oats-center/data-diode/DATA_DIODE_FINAL/mobile/README.md

# Data diode demo mobile app

To start:

```
npm install
npm run dev -- --open
```

# Emulate the position to intersection service

```
nats -s <nats-ip> --user <user> --password <password> reply "light-nearest" '{"intersectionId": 53694, "signalGroup": 4}'
```

# Emulate a GREEN light status update

```
nats -s <server> --user <user> --password <password> publish light-status.53694 '{"id": "53694", "current_time": 1673997750736, "TSCtime": "49947.0", "phases": [{"phase": 1, "color": "RED", "flash": false, "dont_walk": true, "walk": false, "pedestrianClear": false, "overlap": {"green": false, "red":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
```

# Emulate a RED light status update

```
nats -s <server> --user <user> --password <password> publish light-status.53694 '{"id": "53694", "current_time": 1673997750736, "TSCtime": "49947.0", "phases": [{"phase": 1, "color": "RED", "flash": false, "dont_walk": true, "walk": false, "pedestrianClear": false, "overlap": {"green": false, "red":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
```
