oats-center/data-diode/DATA_DIODE_FINAL/NTGS_Conference/NTGS_Conference.pdf

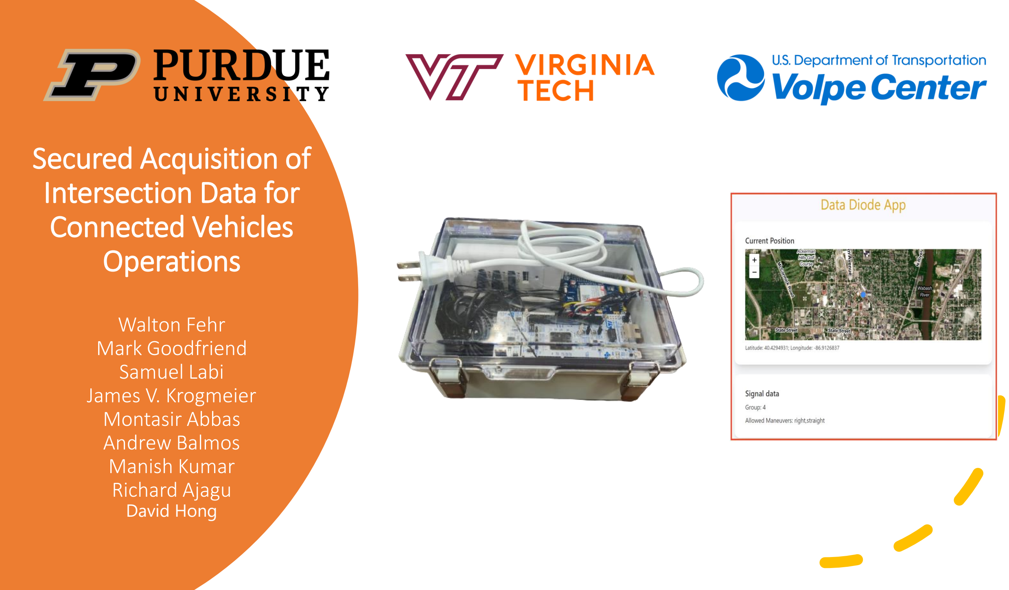
[picture p2: page 1]

Secured Acquisition of
Intersection Data for
Connected Vehicles
Operations

Walton Fehr
Mark Goodfriend
Samuel Labi
James V. Krogmeier
Montasir Abbas
Andrew Balmos
Manish Kumar
Richard Ajagu
David Hong

- Objective is to extract Signal Phase and Timing (SPaT) data from a Traffic Signal Controller (TSC) cabinet
- Solution uses an economical Data-Diode housing two microcontrollers linked via simplex connection
- Diode data is routed to different channels through NATS and stored in Postgres database
- Utilize SPaT data to provide precise timing on driver’s phone
- Backend script detects user location and finds nearest intersection
- User's phone shows TSC lane's light status

Secured Acquisition of Intersection Data for Connected Vehicles Operations

## TSC Cabinet

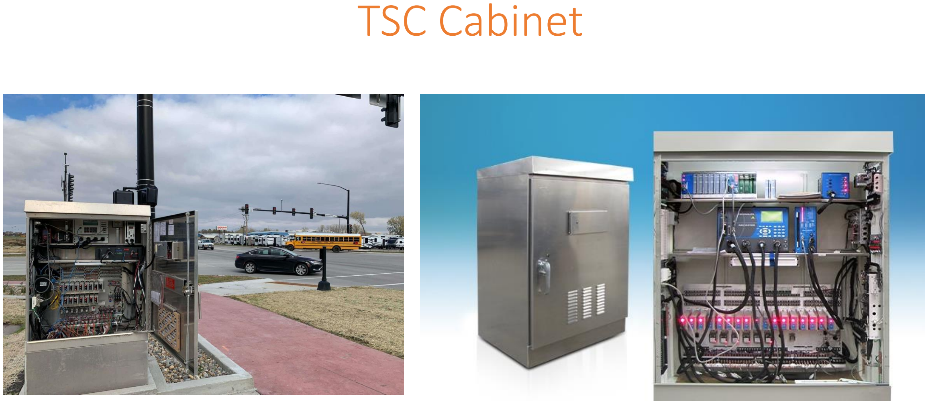
[picture p3: page 3]

## System Workflow

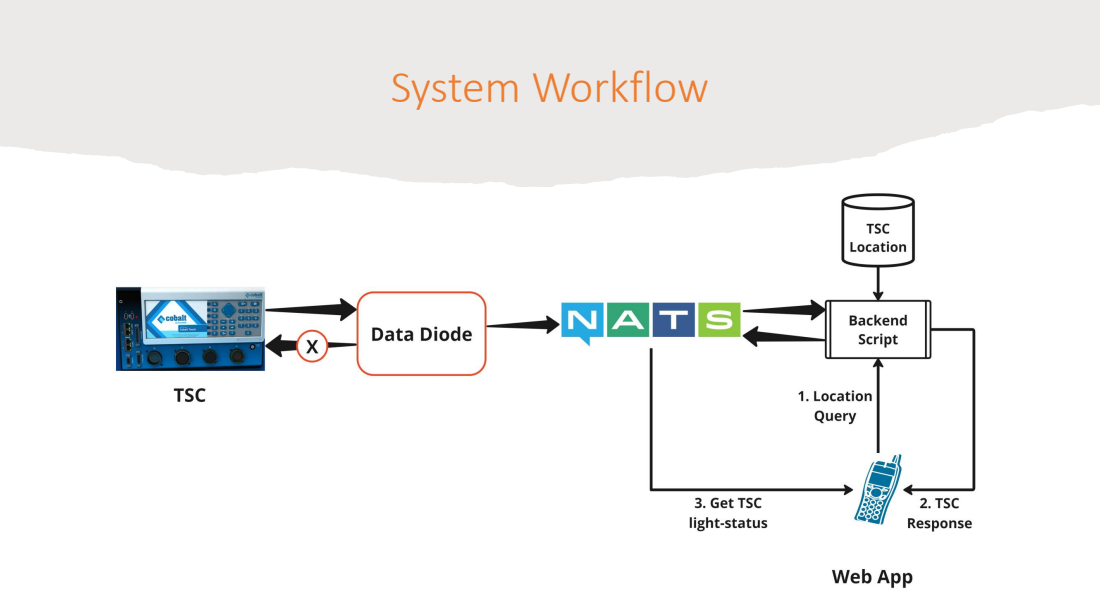
[picture p4: page 4]

## Data-Diode

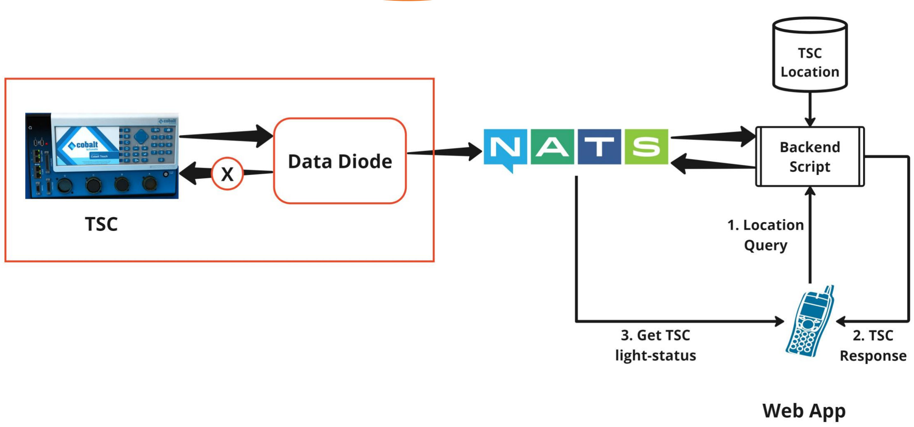
[picture p5: figure]

## Data-Diode

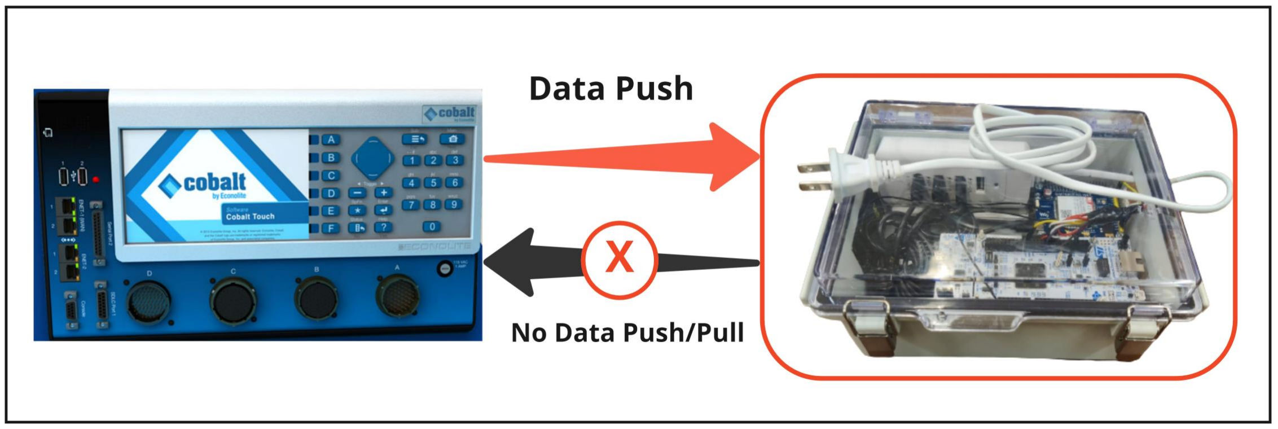
[picture p6: figure]

Components of Data Diode

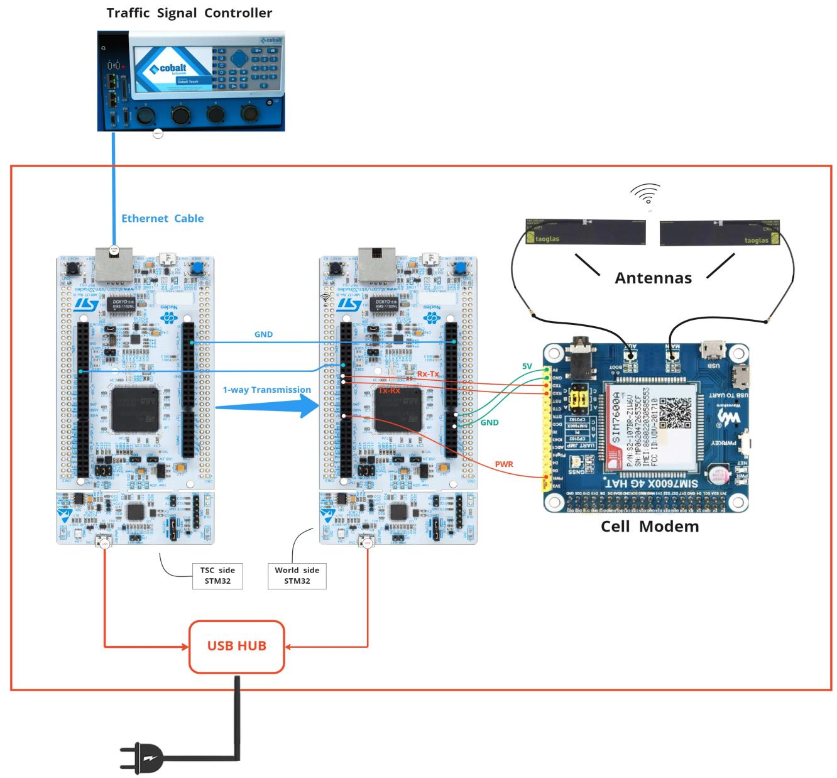
[picture p7: figure]

### NATS Data Routing

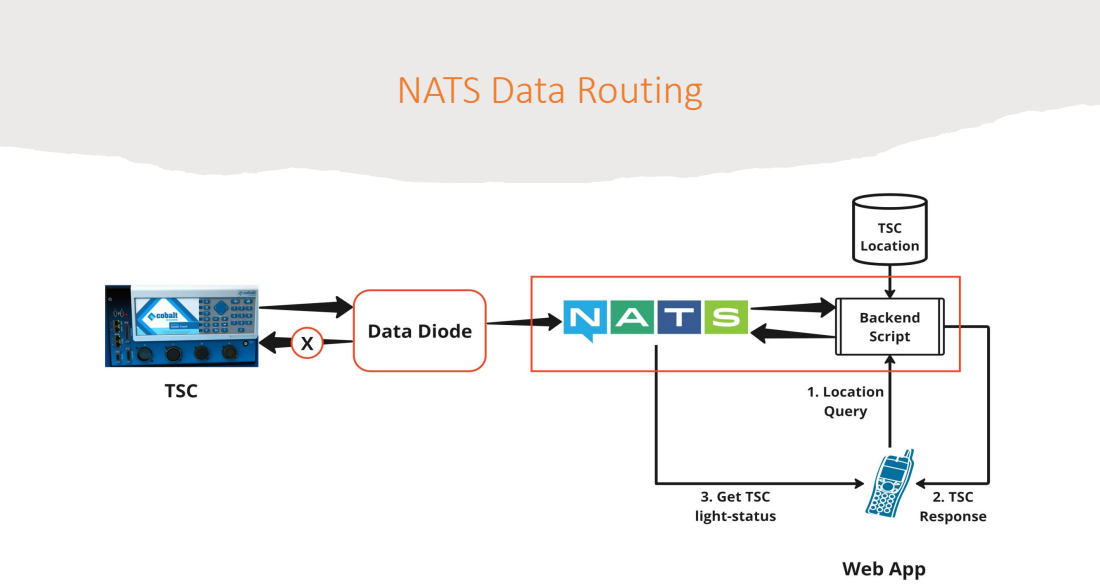
[picture p8: page 8]

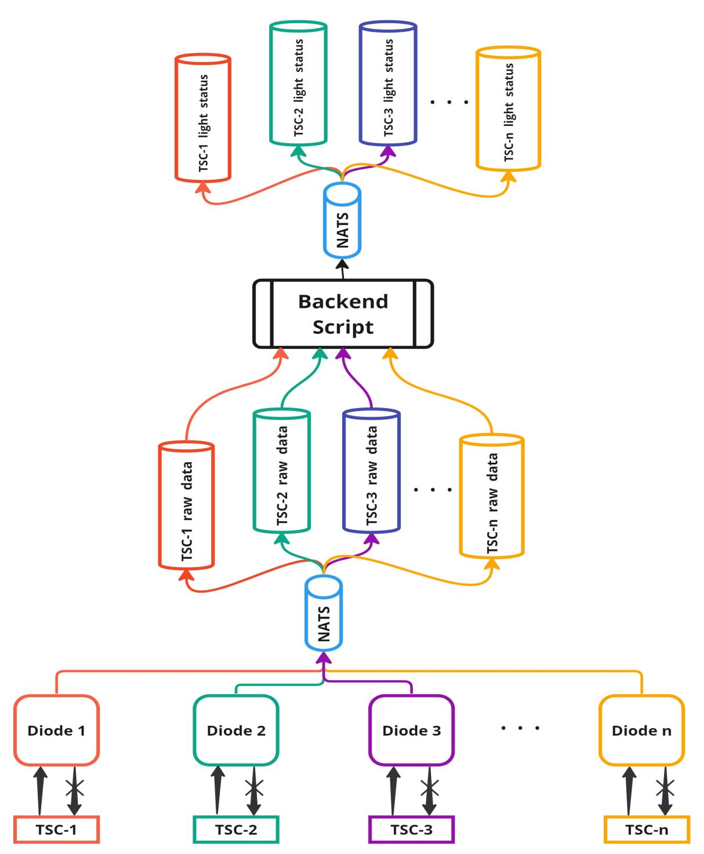
[picture p9: figure]

## Web App

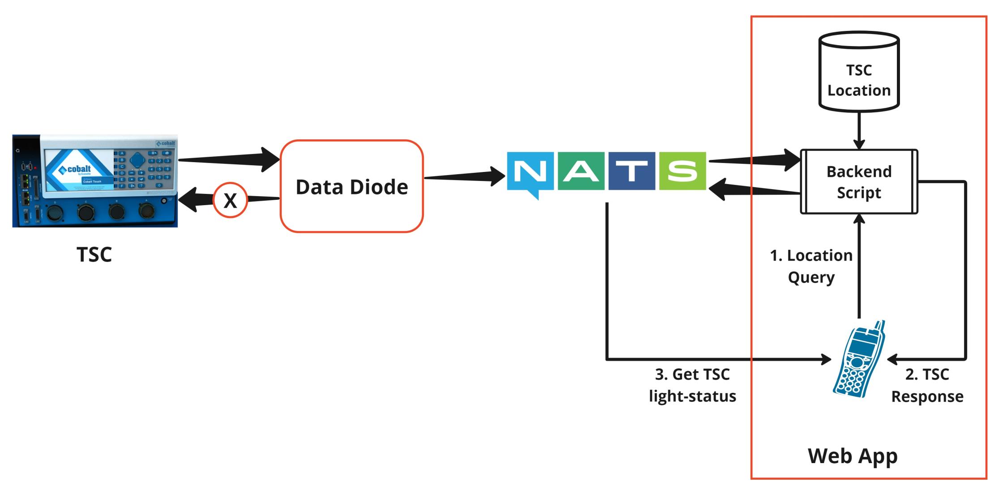
[picture p10: page 10]

## Web App - Backend

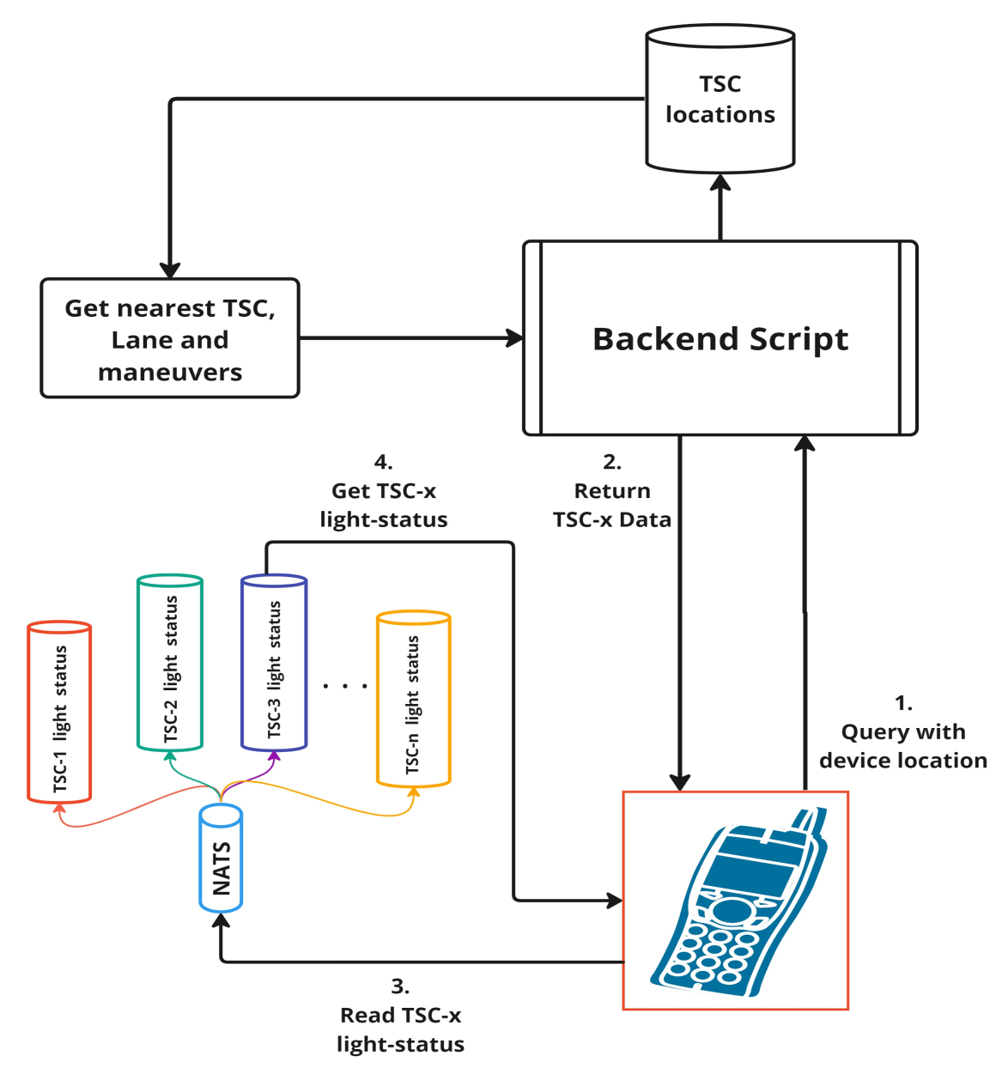
[picture p11: figure]

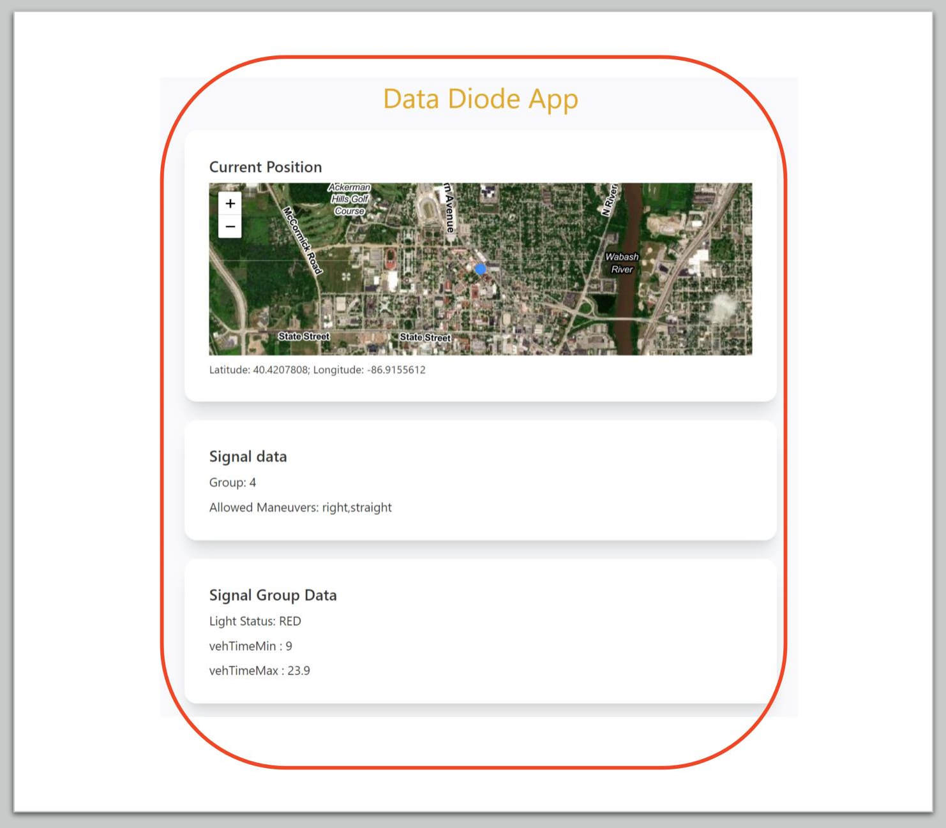
[picture p12: figure]

Web App - Frontend
https://diode.oatscenter.org/
1. Query the server with
coordinates
2. Obtain the Traffic Light status in its lane
3. Display the Light status

## Installation – Plug n Play!

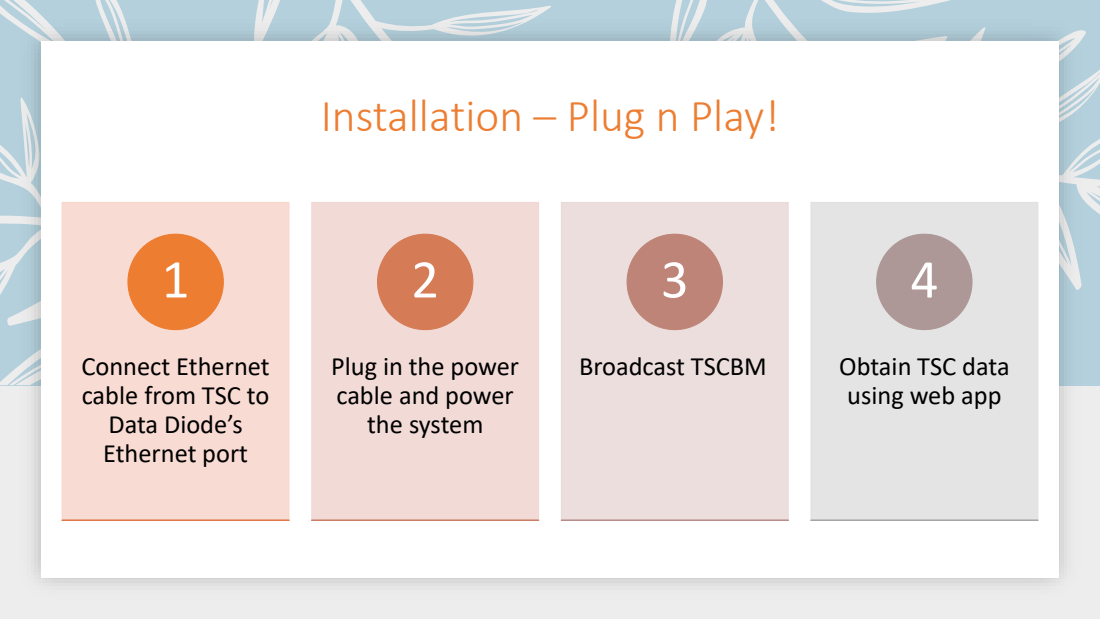
[picture p13: page 13]
Broadcast TSCBM

Connect Ethernet
cable from TSC to
Data Diode’s
Ethernet port

Plug in the power
cable and power
the system

Obtain TSC data
using web app

## Data Diode Goals

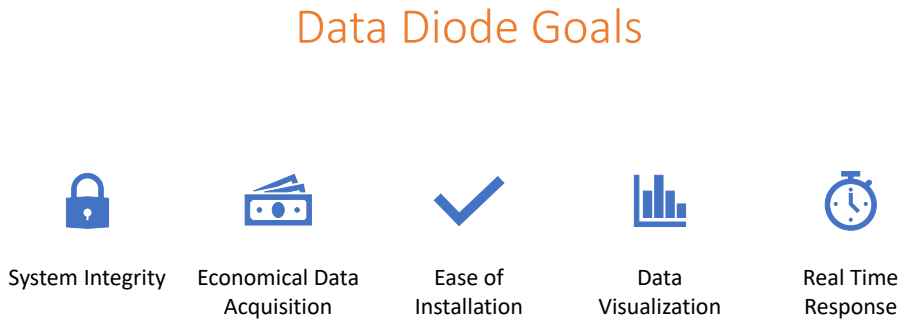
[picture p14: page 14]
System Integrity; Economical Data; Acquisition; Ease of Installation; Data Visualization; Real Time Response

### Demo & Questions

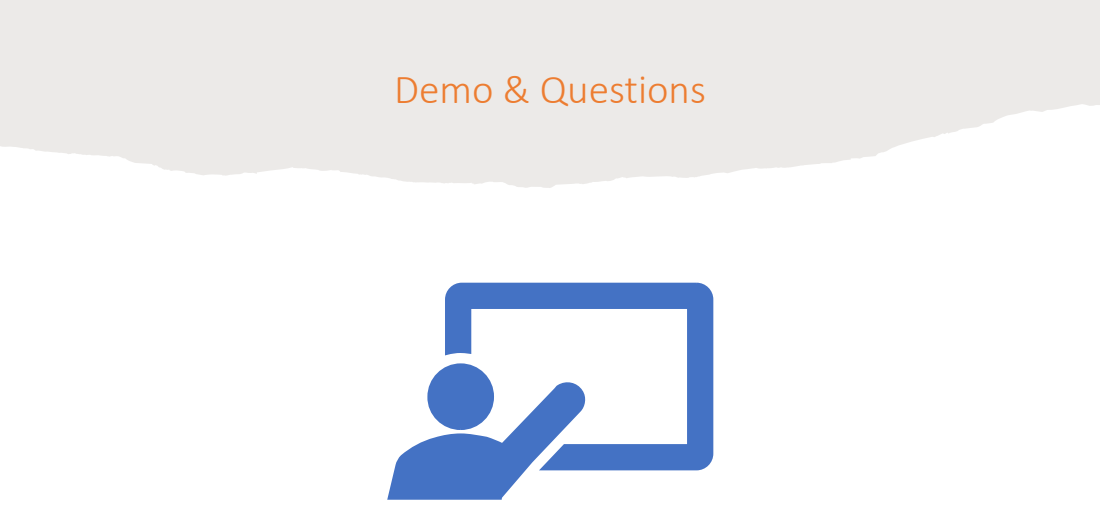
[picture p15: page 15]
