oats-center/data-diode/DATA_DIODE_FINAL/PCB/dev-boards/models/BCS-117-L-D-TE.stp

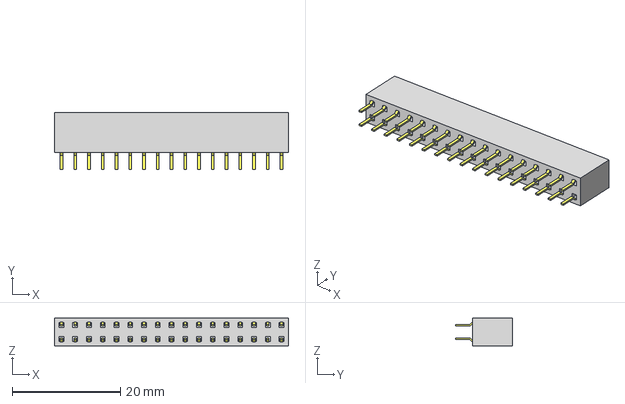
[picture p16: CAD file, 2024-01-05]
DATA_DIODE_FINAL/PCB/dev-boards/models/BCS-117-L-D-TE.stp
43.2 x 10.5 x 5.08 mm
C-95-01-17-D-TE
BCS-117-D-TE_socket
