oats-center/data-diode/DATA_DIODE_FINAL/PCB/dev-boards/models/BCS-115-L-D-TE.stp

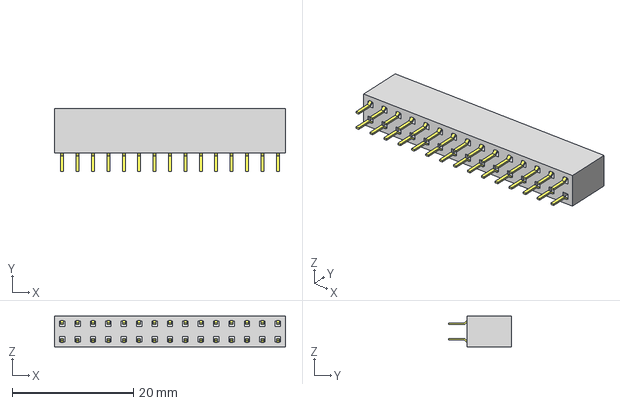
[picture p17: CAD file, 2024-01-05]
DATA_DIODE_FINAL/PCB/dev-boards/models/BCS-115-L-D-TE.stp
38.1 x 10.5 x 5.08 mm
C-95-01-15-D-TE
BCS-115-D-TE_socket
