oats-center/data-diode/DATA_DIODE_FINAL/PCB/dev-boards/models/BCS-110-F-D-TE.stp

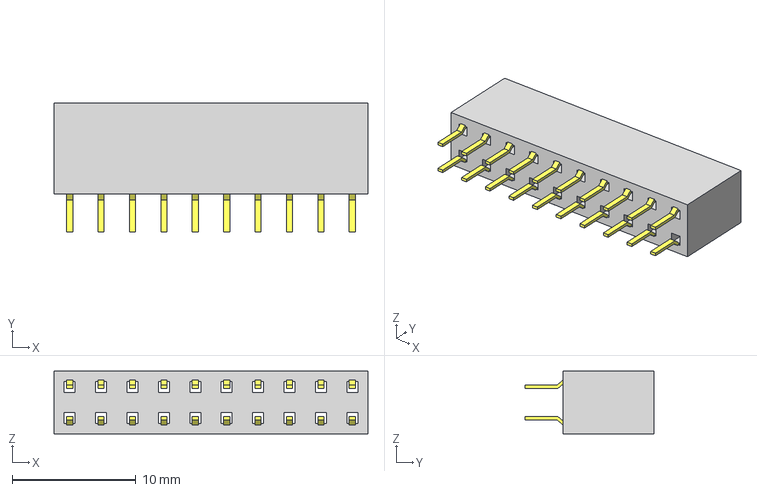
[picture p18: CAD file, 2024-01-05]
DATA_DIODE_FINAL/PCB/dev-boards/models/BCS-110-F-D-TE.stp
25.4 x 10.5 x 5.08 mm
C-95-01-10-D-TE
BCS-110-D-TE_socket
