oats-center/data-diode/DATA_DIODE_FINAL/PCB/dev-boards/models/BCS-108-F-D-TE.stp

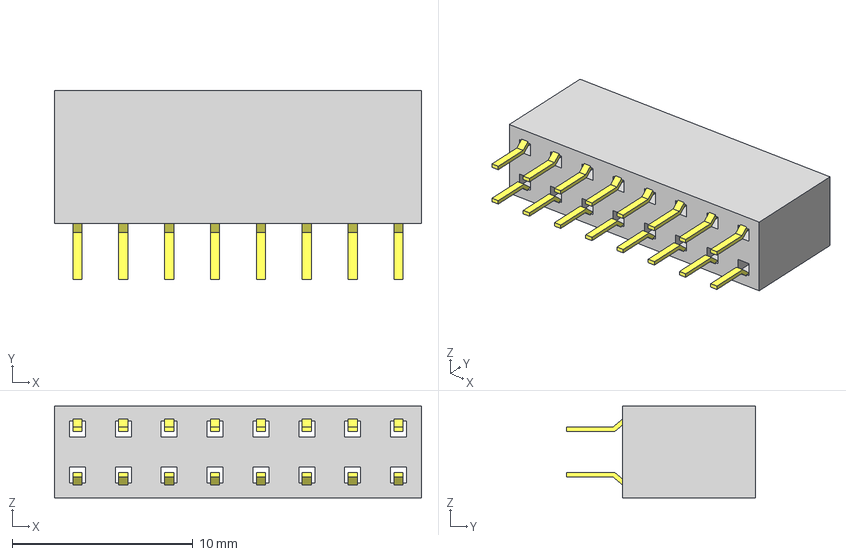
[picture p19: CAD file, 2024-01-05]
DATA_DIODE_FINAL/PCB/dev-boards/models/BCS-108-F-D-TE.stp
20.3 x 10.5 x 5.08 mm
C-95-01-08-D-TE
BCS-108-D-TE_socket
