oats-center/data-diode/DATA_DIODE_FINAL/PCB/dev-boards/models/WQ-48-02-Just-Box.step

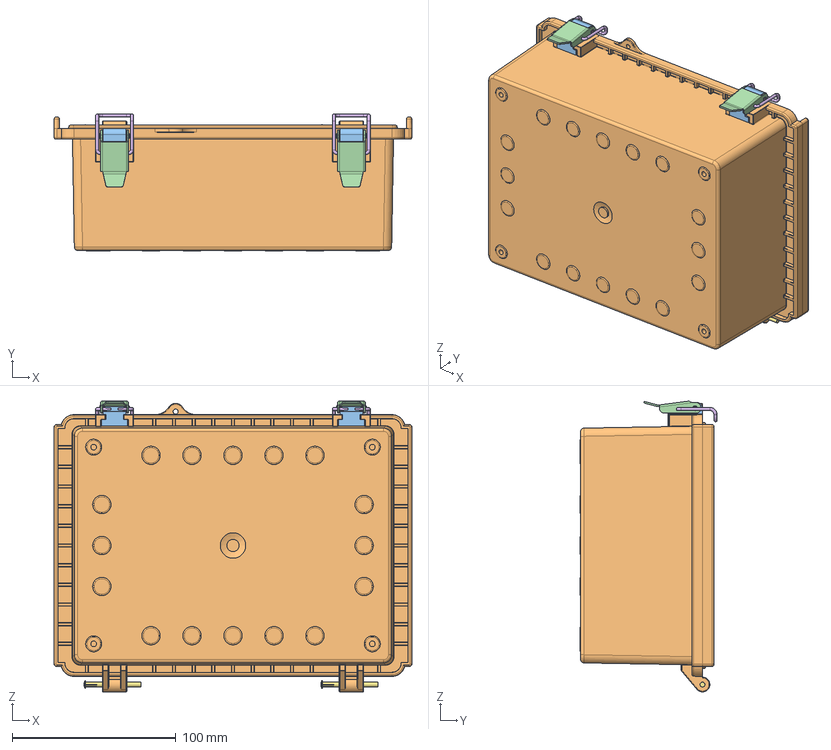
[picture p20: CAD file, 2024-01-05]
DATA_DIODE_FINAL/PCB/dev-boards/models/WQ-48-02-Just-Box.step
218.4 x 83.8 x 177.5 mm
WQ-48B_WQ-48B-02
WQ-48C_WQ-48C-02
BASE^WQ-50L-01 x 2
FRONT^WQ-50L-01_default x 2
PIN^WQ-50L-01 x 2
LOOP^WQ-50L-01 x 2
WQ-PIN-01 x 2
