oats-center/data-diode/DATA_DIODE_FINAL/PCB/new-dev-board/new-dev-board.kicad_pcb

## KiCad design DATA_DIODE_FINAL/PCB/new-dev-board/new-dev-board.kicad_pcb (2024-01-05)

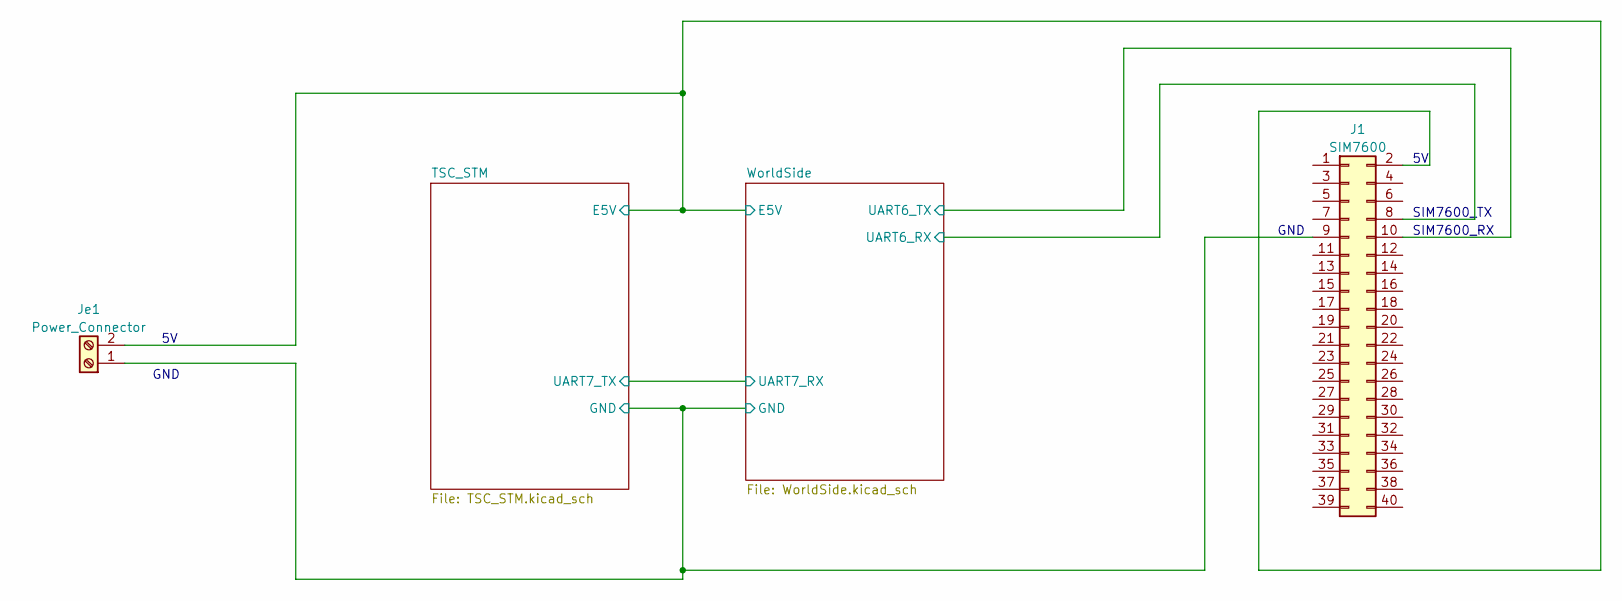
[picture p21: schematic new-dev-board.kicad_sch]

Parts:
J1: SIM7600
Je1: Power_Connector; TerminalBlock_Phoenix_MKDS-1,5-2-5.08_1x02_P5.08mm_Horizont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

Connections:
/TSC_STM/E5V: J1.2, Je1.2; also elsewhere on the board
/TSC_STM/GND: J1.9, Je1.1; also elsewhere on the board
/WorldSide/UART6_RX: J1.8; also elsewhere on the board
/WorldSide/UART6_TX: J1.10; also elsewhere on the board

Notes on the sheet:
GND
SIM7600_TX
SIM7600_RX

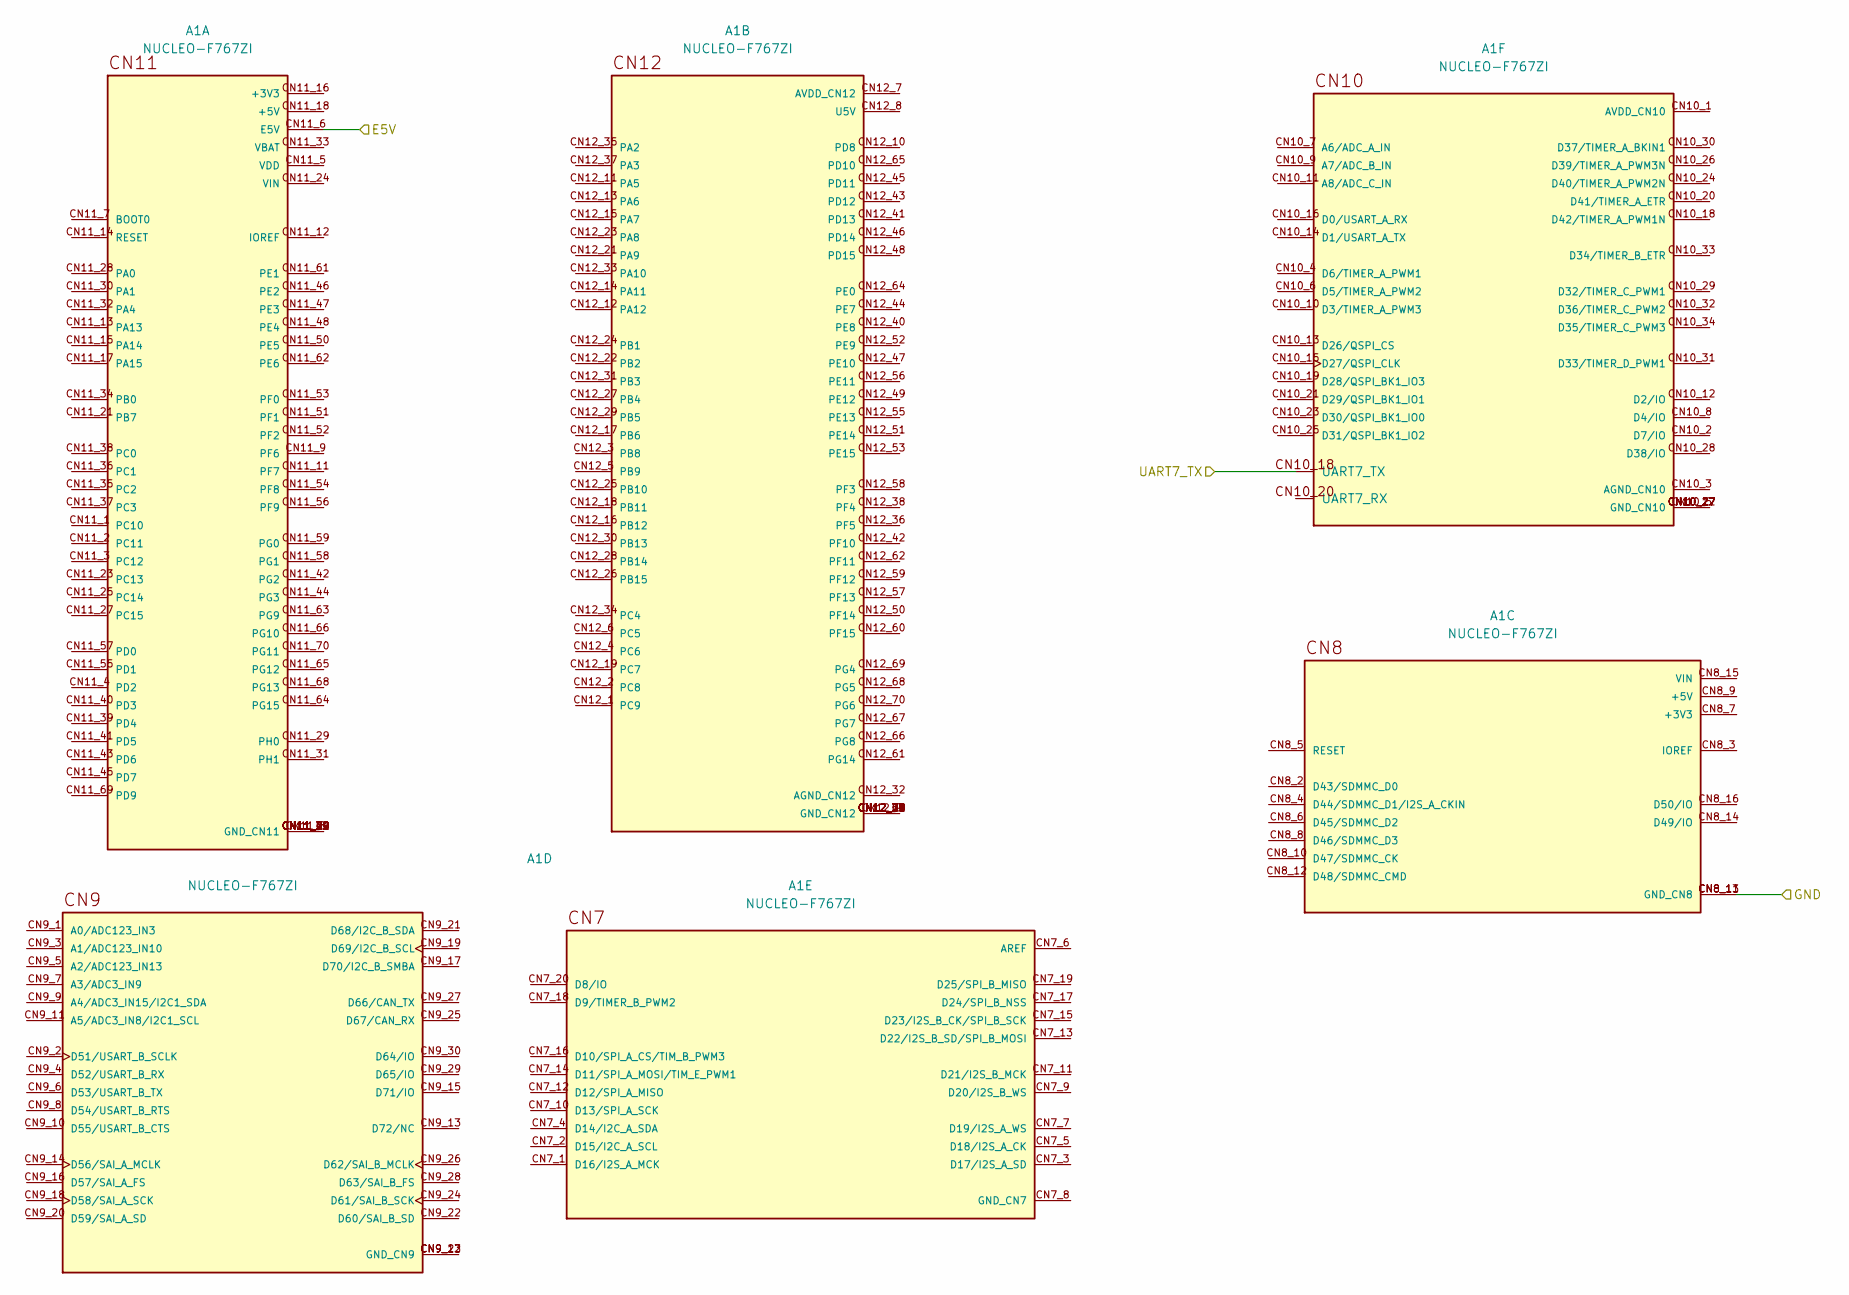
[picture p22: schematic TSC_STM.kicad_sch]

Parts:
A1: NUCLEO-F767ZI; PARTREV 7

Connections:
/TSC_STM/E5V: A1.CN11_6 (E5V); also elsewhere on the board
/TSC_STM/GND: A1.CN8_11 (GND_CN8), A1.CN8_13 (GND_CN8); also elsewhere on the board
/TSC_STM/UART7_TX: A1.CN10_18 (UART7_TX); also elsewhere on the board
unnamed: A1.CN11_8 (GND_CN11), A1.CN11_19 (GND_CN11), A1.CN11_20 (GND_CN11), A1.CN11_22 (GND_CN11), A1.CN11_49 (GND_CN11), A1.CN11_60 (GND_CN11), A1.CN11_71 (GND_CN11), A1.CN11_72 (GND_CN11)
unnamed: A1.CN12_9 (GND_CN12), A1.CN12_20 (GND_CN12), A1.CN12_39 (GND_CN12), A1.CN12_54 (GND_CN12), A1.CN12_63 (GND_CN12), A1.CN12_71 (GND_CN12), A1.CN12_72 (GND_CN12)
unnamed: A1.CN9_12 (GND_CN9), A1.CN9_23 (GND_CN9)
unnamed: A1.CN10_5 (GND_CN10), A1.CN10_17 (GND_CN10), A1.CN10_22 (GND_CN10), A1.CN10_27 (GND_CN10)

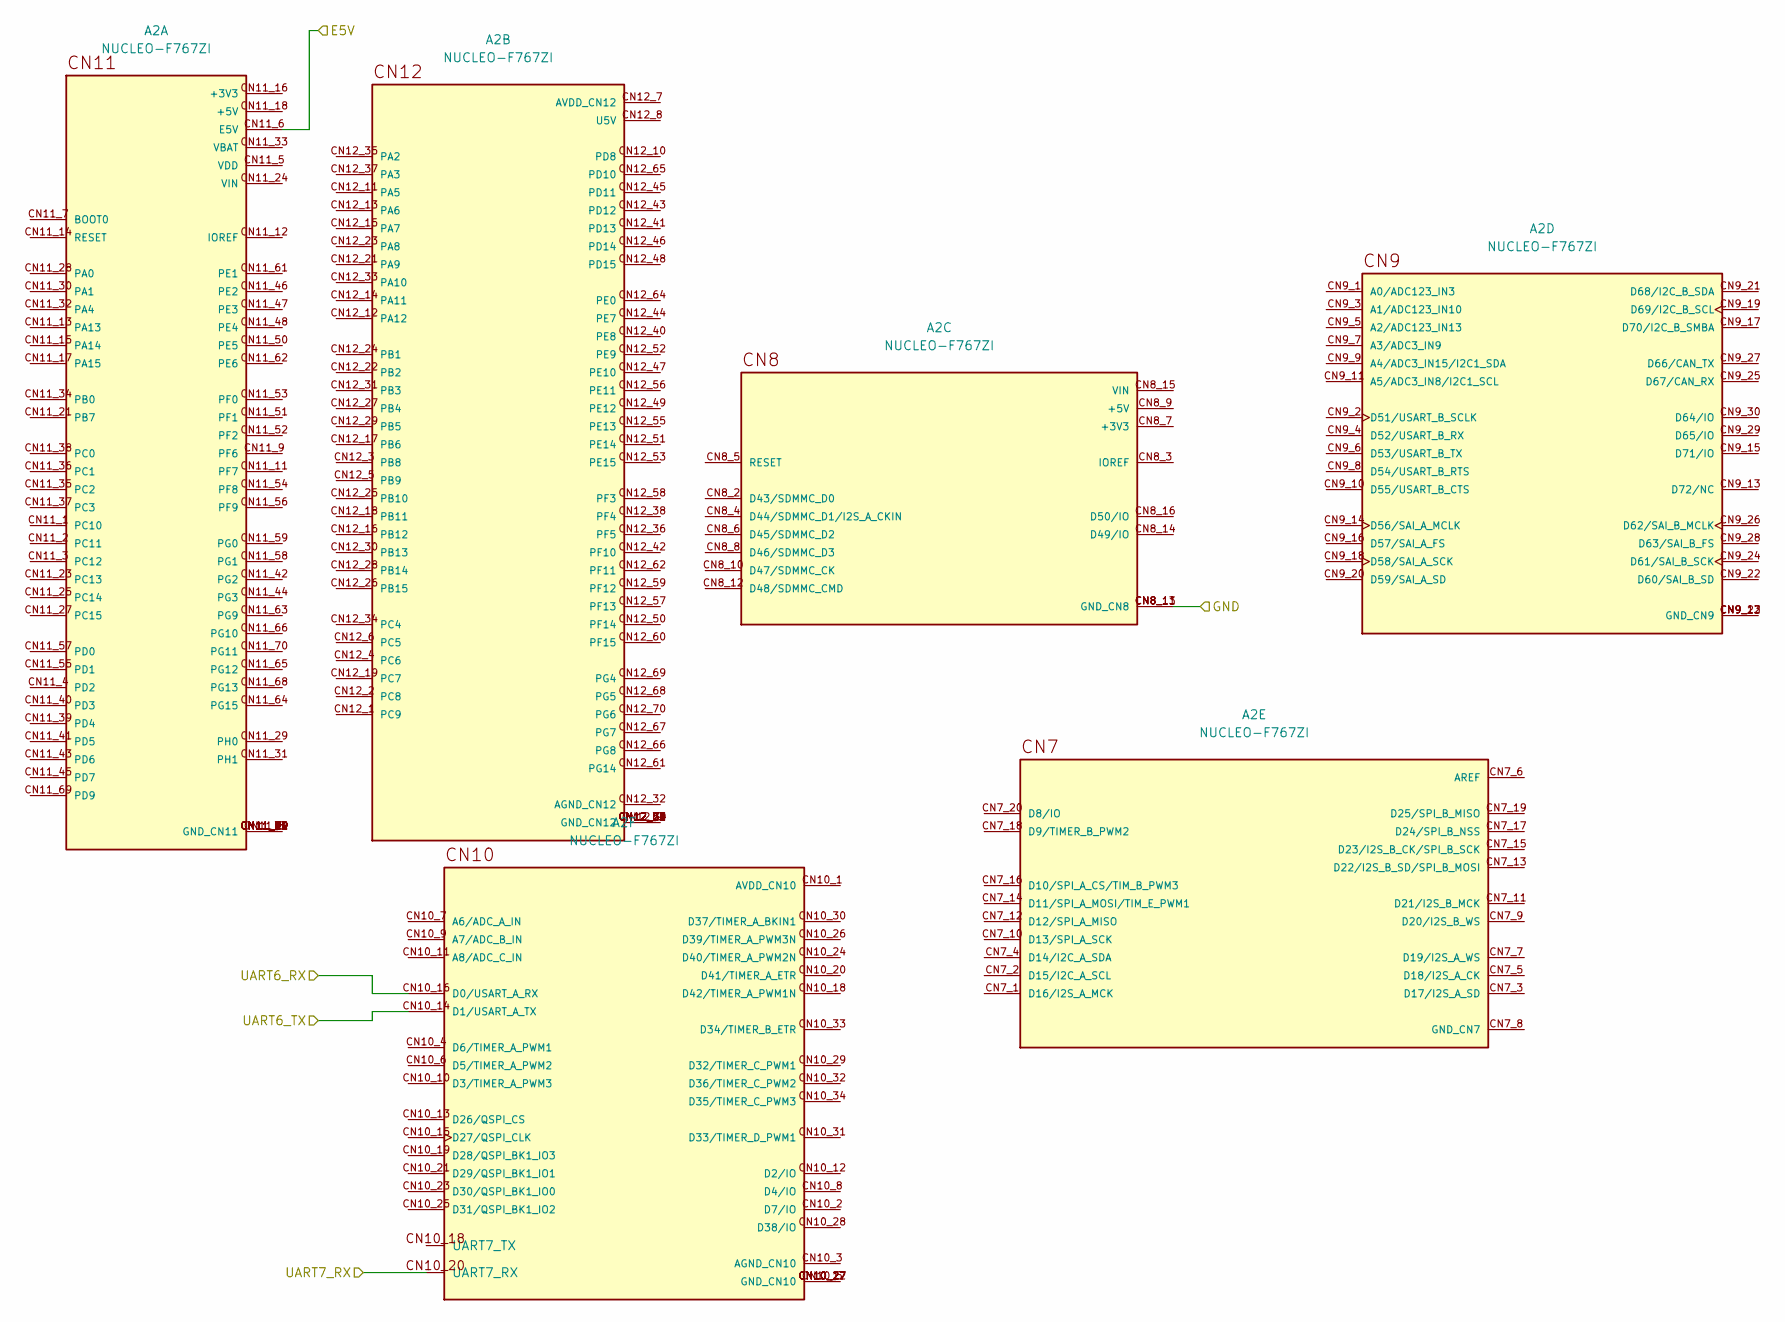
[picture p23: schematic WorldSide.kicad_sch]

Parts:
A2: NUCLEO-F767ZI; PARTREV 7

Connections:
/TSC_STM/E5V: A2.CN11_6 (E5V); also elsewhere on the board
/TSC_STM/GND: A2.CN8_11 (GND_CN8), A2.CN8_13 (GND_CN8); also elsewhere on the board
/TSC_STM/UART7_TX: A2.CN10_20 (UART7_RX); also elsewhere on the board
/WorldSide/UART6_RX: A2.CN10_16 (D0/USART_A_RX); also elsewhere on the board
/WorldSide/UART6_TX: A2.CN10_14 (D1/USART_A_TX); also elsewhere on the board
unnamed: A2.CN11_8 (GND_CN11), A2.CN11_19 (GND_CN11), A2.CN11_20 (GND_CN11), A2.CN11_22 (GND_CN11), A2.CN11_49 (GND_CN11), A2.CN11_60 (GND_CN11), A2.CN11_71 (GND_CN11), A2.CN11_72 (GND_CN11)
unnamed: A2.CN12_9 (GND_CN12), A2.CN12_20 (GND_CN12), A2.CN12_39 (GND_CN12), A2.CN12_54 (GND_CN12), A2.CN12_63 (GND_CN12), A2.CN12_71 (GND_CN12), A2.CN12_72 (GND_CN12)
unnamed: A2.CN9_12 (GND_CN9), A2.CN9_23 (GND_CN9)
unnamed: A2.CN10_5 (GND_CN10), A2.CN10_17 (GND_CN10), A2.CN10_22 (GND_CN10), A2.CN10_27 (GND_CN10)

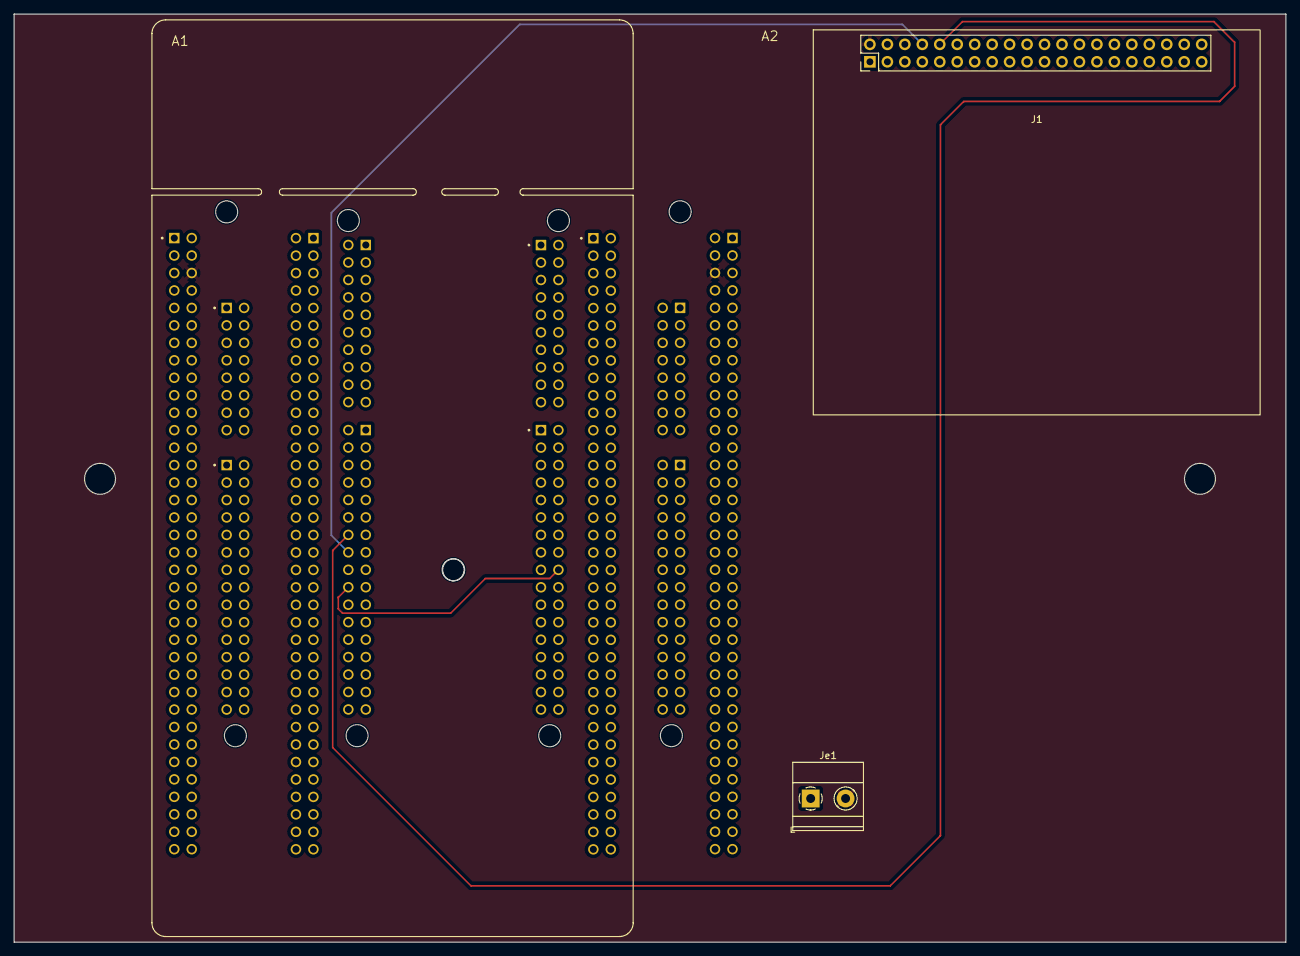
[picture p24: board new-dev-board.kicad_pcb from above]

Board: 2 copper layers, 185.0 x 135.0 mm, 4 parts (1 on the bottom side), 13 nets.
