oats-center/data-diode/DATA_DIODE_FINAL/PCB/dev-boards/dev-boards.kicad_pcb

## KiCad design DATA_DIODE_FINAL/PCB/dev-boards/dev-boards.kicad_pcb (2024-01-05)

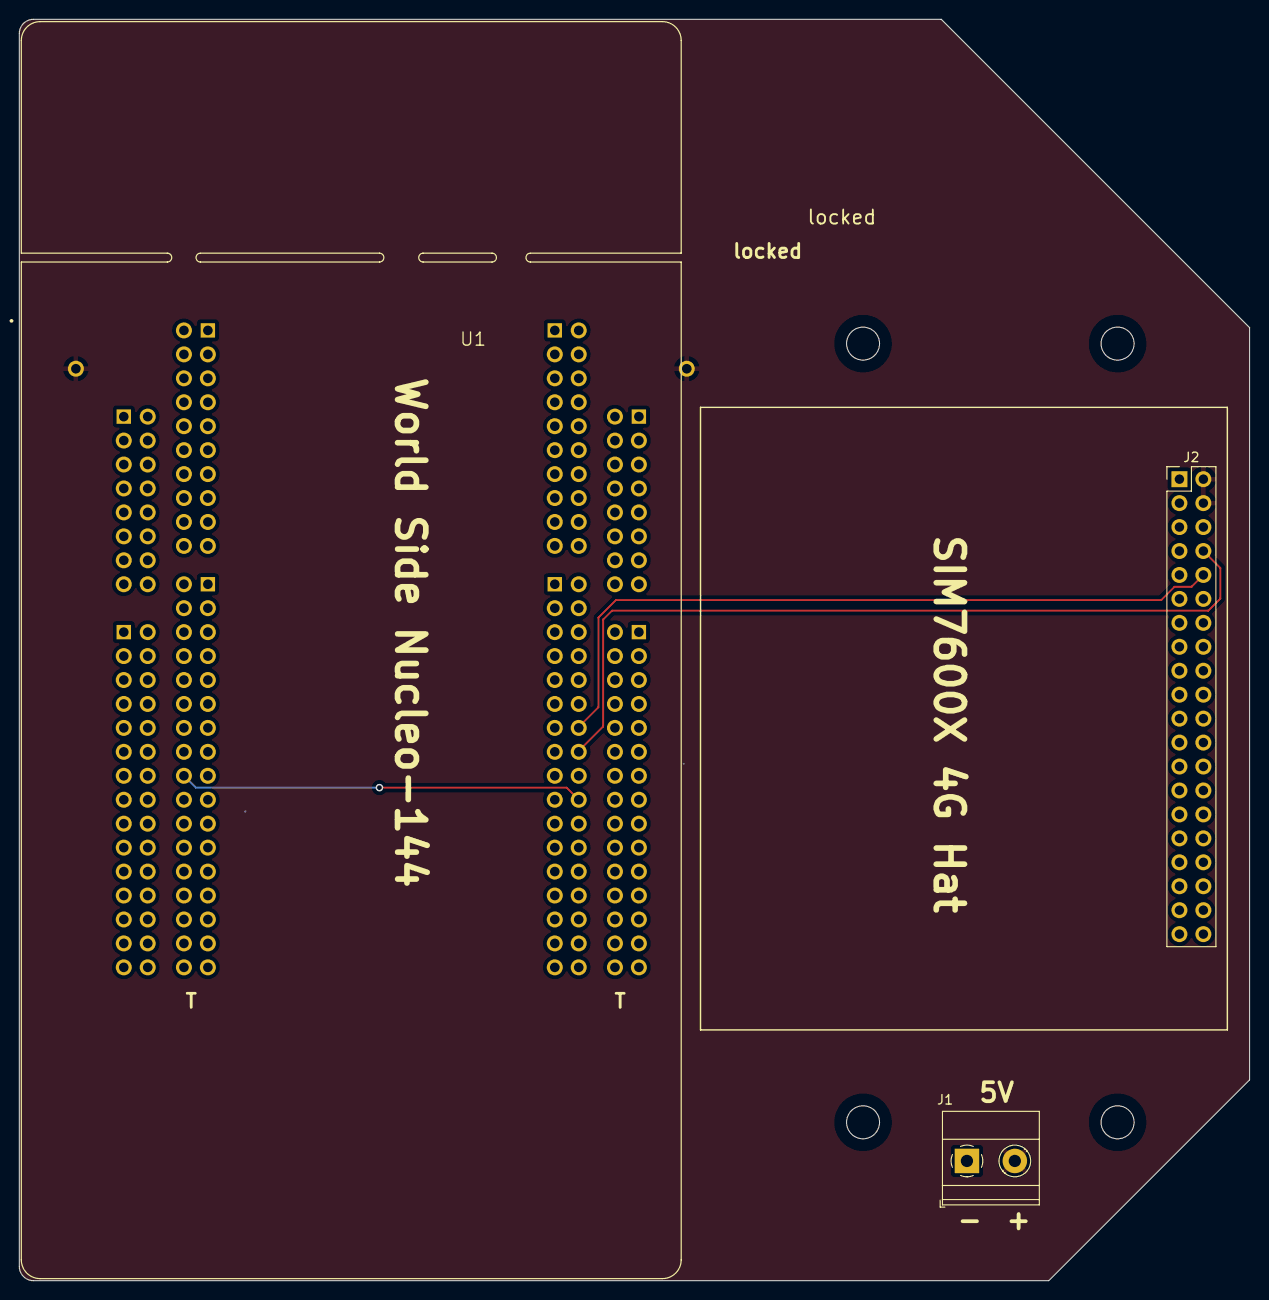
[picture p25: board dev-boards.kicad_pcb from above]

Board: 2 copper layers, 130.5 x 133.8 mm, 9 parts (1 on the bottom side), 5 nets.

Parts:
H1, H2, H3, H4: MountingHole; MountingHole_3.5mm
J1: 5V Input; TerminalBlock_Phoenix_MKDS-1,5-2-5.08_1x02_P5.08mm_Horizont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
J2: SIM7600 Cell Header; PinHeader_2x20_P2.54mm_Vertical
N1: Housing; oats_logo
U1, U2: NUCLEO-F429ZI; MODULE_NUCLEO-F429ZI

Connections:
+5V: J1.2, J2.2, J2.4, U1.CN11_6 (E5V), U2.CN11_6 (E5V)
/M_RX_TX: J2.10, U1.CN10_14 (D1/USART_A_TX)
/M_TX_RX: J2.8, U1.CN10_16 (D0/USART_A_RX)
/TSC Side Sheet/D_TX: U1.CN10_20 (D41/TIMER_A_ETR), U2.CN10_18 (D42/TIMER_A_PWM1N)
GND: J1.1, J2.6, J2.9, J2.14, J2.20, J2.25, J2.30, J2.34, J2.39, U1.CN7_8 (GND_CN7), U1.CN8_11 (GND_CN8), U1.CN8_13 (GND_CN8), U1.CN9_12 (GND_CN9), U1.CN9_23 (GND_CN9), U1.CN10_3 (AGND_CN10), U1.CN10_5 (GND_CN10), U1.CN10_17 (GND_CN10), U1.CN10_22 (GND_CN10), U1.CN10_27 (GND_CN10), U2.CN7_8 (GND_CN7), U2.CN8_11 (GND_CN8), U2.CN8_13 (GND_CN8), U2.CN9_12 (GND_CN9), U2.CN9_23 (GND_CN9), U2.CN10_3 (AGND_CN10), U2.CN10_5 (GND_CN10), U2.CN10_17 (GND_CN10), U2.CN10_22 (GND_CN10), U2.CN10_27 (GND_CN10)
