oats-center/data-diode/DATA_DIODE_FINAL/Data_Diode_efficient_heap_based/World_Side_STM32/ArduinoNATS.h

#ifndef ARDUINO_NATS_H
#define ARDUINO_NATS_H
#if defined(ARDUINO) && ARDUINO >= 100
#include "Arduino.h"
#elif defined(SPARK)
#include "application.h"
#endif
#include "ModemClient.h"

#define NATS_CLIENT_LANG "arduino"
#define NATS_CLIENT_VERSION "1.0.0"

#ifndef NATS_CONF_VERBOSE
#define NATS_CONF_VERBOSE false
#endif

#ifndef NATS_CONF_PEDANTIC
#define NATS_CONF_PEDANTIC false
#endif

#ifndef NATS_PING_INTERVAL
#define NATS_PING_INTERVAL 25000UL
#endif

#ifndef NATS_RECONNECT_INTERVAL
#define NATS_RECONNECT_INTERVAL 5000UL
#endif

#define NATS_DEFAULT_PORT 4222

#define NATS_INBOX_PREFIX "_INBOX."
#define NATS_INBOX_ID_LENGTH 22

#define NATS_MAX_ARGV 5

#define NATS_CR_LF "\r\n"
#define NATS_CTRL_MSG "MSG"
#define NATS_CTRL_OK "+OK"
#define NATS_CTRL_ERR "-ERR"
#define NATS_CTRL_PING "PING"
#define NATS_CTRL_PONG "PONG"
#define NATS_CTRL_INFO "INFO"

namespace NATSUtil {

static const char alphanums[] =
  "0123456789abcdefghijklmnopqrstuvwxyzABCDEFGHIJKLMNOPQRSTUVWXYZ";

class MillisTimer {
  const unsigned long interval;
  unsigned long t;

public:
  MillisTimer(const unsigned long interval)
    : interval(interval) {}
  bool process() {
    unsigned long ms = millis();
    if (ms < t || (ms - t) > interval) {
      t = ms;
      return true;
    }
    return false;
  }
};

template<typename T> class Array {
private:
  T *data;
  size_t len;
  size_t cap;

public:
  Array(size_t cap = 32)
    : len(0), cap(cap) {
    data = (T *)malloc(cap * sizeof(T));
  }

  ~Array() {
    free(data);
  }

private:
  void resize() {
    if (cap == 0)
      cap = 1;
    else
      cap *= 2;
    data = (T *)realloc(data, cap * sizeof(T));
  }

public:
  size_t const size() const {
    return len;
  };

  void erase(size_t idx) {
    for (size_t i = idx; i < len; i++) {
      data[i] = data[i + 1];
    }
    len--;
  }

  void empty() {
    len = 0;
    cap = 32;
    free(data);
    data = (T *)malloc(cap * sizeof(T));
  }

  T const &operator[](size_t i) const {
    return data[i];
  }

  T &operator[](size_t i) {
    while (i >= cap)
      resize();
    return data[i];
  }

  size_t push_back(T v) {
    size_t i = len++;
    if (len > cap)
      resize();
    data[i] = v;
    return i;
  }

  T *ptr() {
    return data;
  }
};

template<typename T> class Queue {

private:
  class Node {
  public:
    T data;
    Node *next;
    Node(T data, Node *next = NULL)
      : data(data), next(next) {}
  };
  Node *root;
  size_t len;

public:
  Queue()
    : root(NULL), len(0) {}
  ~Queue() {
    Node *tmp;
    Node *n = root;
    while (n != NULL) {
      tmp = n->next;
      free(n);
      n = tmp;
    }
  }
  bool empty() const {
    return root == NULL;
  }
  size_t const size() const {
    return len;
  }
  void push(T data) {
    root = new Node(data, root);
    len++;
  }
  T pop() {
    Node n = *root;
    free(root);
    root = n.next;
    len--;
    return n.data;
  }
  T peek() {
    return root->data;
  }
};

};  // namespace NATSUtil

class NATS {

  // Structures/Types ----------------------------------------- //

public:
  typedef struct {
    const char *subject;
    const int sid;
    const char *reply;
    const char *data;
    const int size;
  } msg;

private:
  typedef void (*sub_cb)(msg e);
  typedef void (*event_cb)();

  class Sub {
  public:
    sub_cb cb;
    int received;
    int max_wanted;
    Sub(sub_cb cb, int max_wanted = 0)
      : cb(cb), received(0), max_wanted(max_wanted) {}
    void call(msg &e) {
      received++;
      cb(e);
    }
    bool maxed() {
      return (max_wanted == 0) ? false : received >= max_wanted;
    }
  };

  // Members --------------------------------------------- //

private:
  ModemClient *client;

  const char *hostname;
  const int port;
  const char *user;
  const char *pass;

  NATSUtil::Array<Sub *> subs;
  NATSUtil::Queue<size_t> free_sids;

  NATSUtil::MillisTimer ping_timer;
  NATSUtil::MillisTimer reconnect_timer;

  int outstanding_pings;
  int reconnect_attempts;

public:
  bool connected = false;

  int max_outstanding_pings;
  int max_reconnect_attempts;

  event_cb on_connect;
  event_cb on_disconnect;
  event_cb on_error;

  // Constructor ----------------------------------------- //

public:
  NATS(ModemClient *client, const char *hostname, int port = NATS_DEFAULT_PORT,
       const char *user = NULL, const char *pass = NULL)
    : client(client), hostname(hostname), port(port), user(user), pass(pass),
      ping_timer(NATS_PING_INTERVAL),
      reconnect_timer(NATS_RECONNECT_INTERVAL), outstanding_pings(0),
      reconnect_attempts(0), connected(false), max_outstanding_pings(3),
      max_reconnect_attempts(-1), on_connect(NULL), on_disconnect(NULL),
      on_error(NULL) {}

  // Methods --------------------------------------------- //

private:
  void send(const char *msg) {
    if (msg == NULL)
      return;
    client->write((uint8_t *)msg, strlen(msg));
  }

  int vasprintf(char **strp, const char *fmt, va_list ap) {
    va_list ap2;
    va_copy(ap2, ap);
    char tmp[1];
    int size = vsnprintf(tmp, 1, fmt, ap2);
    if (size <= 0)
      return size;
    va_end(ap2);
    size += 1;
    *strp = (char *)malloc(size * sizeof(char));
    return vsnprintf(*strp, size, fmt, ap);
  }

  void send_fmt(const char *fmt, ...) {
    va_list args;
    va_start(args, fmt);
    char *buf;
    vasprintf(&buf, fmt, args);
    va_end(args);
    send(buf);
    free(buf);
  }

  void send_connect() {
    send_fmt(
      "CONNECT {"
      "\"verbose\": %s,"
      "\"pedantic\": %s,"
      "\"lang\": \"%s\","
      "\"version\": \"%s\","
      "\"user\": \"%s\","
      "\"pass\": \"%s\""
      "}\r\n",
      NATS_CONF_VERBOSE ? "true" : "false",
      NATS_CONF_PEDANTIC ? "true" : "false",
      NATS_CLIENT_LANG,
      NATS_CLIENT_VERSION,
      (user == NULL) ? "null" : user,
      (pass == NULL) ? "null" : pass);

    if (!connected) {
        connected = true;
        if (on_connect != NULL) {
          on_connect();
        }
      }
  }

  void recv() {
    char *buf = client->getline();
    if (buf == NULL) {
      return;
    }

    // tokenize line by space
    size_t argc = 0;
    const char *argv[NATS_MAX_ARGV] = {};
    for (int i = 0; i < NATS_MAX_ARGV; i++) {
      argv[i] = strtok((i == 0) ? buf : NULL, " ");
      if (argv[i] == NULL)
        break;
      argc++;
    }

    // switch off of control keyword
    if (argc == 0) {
    } else if (strcmp(argv[0], NATS_CTRL_MSG) == 0) {
      // sanity check
      if (argc != 4 && argc != 5) {
        free(buf);
        return;
      }

      // get subscription id
      int sid = atoi(argv[2]);
      // make sure sub for sid is not null
      if (subs[sid] == NULL) {
        free(buf);
        return;
      };

      // receive payload
      int payload_size = atoi((argc == 5) ? argv[4] : argv[3]) + 1;

      char *payload_buf;
      // FIXME: We really don't want to block here... but I don't see a quick workaround at the moment.
      while ((payload_buf = client->getline()) != NULL) {
        // Block untill message is RX'd
      }

      // put data into event struct
      msg e = { argv[1], sid, (argc == 5) ? argv[3] : "", payload_buf,
                payload_size };

      // call callback
      subs[sid]->call(e);
      if (subs[sid]->maxed())
        unsubscribe(sid);

      free(payload_buf);
    } else if (strcmp(argv[0], NATS_CTRL_OK) == 0) {
    } else if (strcmp(argv[0], NATS_CTRL_ERR) == 0) {
      if (on_error != NULL)
        on_error();
      disconnect();
    } else if (strcmp(argv[0], NATS_CTRL_PING) == 0) {
      send(NATS_CTRL_PONG "\r\n");
    } else if (strcmp(argv[0], NATS_CTRL_PONG) == 0) {
      outstanding_pings--;
    } else if (strcmp(argv[0], NATS_CTRL_INFO) == 0) {
      send_connect();
    }

    free(buf);
  }

  void ping() {
    if (outstanding_pings > max_outstanding_pings) {
      DEBUG_PRINT("[WARN] nats went away?");
      client->stop();
      return;
    }
    outstanding_pings++;
    send(NATS_CTRL_PING "\r\n");
  }

  char *generate_inbox_subject() {
    size_t size =
      (sizeof(NATS_INBOX_PREFIX) + NATS_INBOX_ID_LENGTH) * sizeof(char);
    char *buf = (char *)malloc(size);
    strcpy(buf, NATS_INBOX_PREFIX);
    int i;
    for (i = sizeof(NATS_INBOX_PREFIX) - 1; i < size - 1; i++) {
      int random_idx = random(sizeof(NATSUtil::alphanums) - 1);
      buf[i] = NATSUtil::alphanums[random_idx];
    }
    buf[i] = '\0';
    return buf;
  }

public:
  bool connect() {
    if (client->connect(hostname, port)) {
      outstanding_pings = 0;
      reconnect_attempts = 0;
      return true;
    }
    reconnect_attempts++;
    return false;
  }

  void disconnect() {
    if (!connected)
      return;
    connected = false;
    client->stop();
    subs.empty();
    if (on_disconnect != NULL)
      on_disconnect();
  }

  void publish(const char *subject, const char *msg = NULL,
               const char *replyto = NULL) {
    if (subject == NULL || subject[0] == 0)
      return;
    if (!connected)
      return;
    if (!client->connected()) {
      connected = false;
      return;
    }
    send_fmt("PUB %s %s %lu\r\n",
             subject,
             (replyto == NULL) ? "" : replyto,
             (unsigned long)strlen(msg));
    send((msg == NULL) ? "" : msg);
    send("\r\n");
  }
  void publish(const char *subject, const bool msg) {
    publish(subject, (msg) ? "true" : "false");
  }
  void publishf(const char *subject, const char *fmt, ...) {
    va_list args;
    va_start(args, fmt);
    char *buf;
    vasprintf(&buf, fmt, args);
    va_end(args);
    publish(subject, buf);
    free(buf);
  }

  int subscribe(const char *subject, sub_cb cb, const char *queue = NULL,
                const int max_wanted = 0) {
    if (!connected)
      return -1;
    Sub *sub = new Sub(cb, max_wanted);

    int sid;
    if (free_sids.empty()) {
      sid = subs.push_back(sub);
    } else {
      sid = free_sids.pop();
      subs[sid] = sub;
    }

    send_fmt("SUB %s %s %d\r\n", subject, (queue == NULL) ? "" : queue, sid);
    return sid;
  }

  void unsubscribe(const int sid) {
    if (!connected)
      return;
    send_fmt("UNSUB %d\r\n", sid);
    free(subs[sid]);
    subs[sid] = NULL;
    free_sids.push(sid);
  }

  int request(const char *subject, const char *msg, sub_cb cb,
              const int max_wanted = 1) {
    if (subject == NULL || subject[0] == 0)
      return -1;
    if (!connected)
      return -1;
    char *inbox = generate_inbox_subject();
    int sid = subscribe(inbox, cb, NULL, max_wanted);
    publish(subject, msg, inbox);
    free(inbox);
    return sid;
  }

  void process() {
    if (client->connected()) {
      if (client->available()) {
        recv();
      }
/*
     if (ping_timer.process()) {
      if(connected) {
        ping();
      }
     }
*/
    } else {
      disconnect();

      if (max_reconnect_attempts == -1 || reconnect_attempts < max_reconnect_attempts) {
        if (reconnect_timer.process())
          connect();
      }
    }
  }
};

#endif
