oats-center/data-diode/DATA_DIODE_FINAL/Data_Diode_efficient_heap_based/World_Side_STM32/ModemClient.h

#ifndef INCLUDE_MODEM_CLIENT_H
#define INCLUDE_MODEM_CLIENT_H

#include "CircularBuffer.h"
#include "MemoryBuffer.h"
#include <Arduino.h>
#include <stdio.h>
#include <stdlib.h>

#define MODEM_BAUD_RATE 115200
#define MODEM_MTU 1500
#define DEFAULT_POLL_COUNT 20  //set default reset time to 20 sec
// Note: Measuring time is hard when the clock can overflow. Instead, compute
// and compare durations
// Checks if it has been at least x milliseconds since the last TIME_MARK()
#define TIME_HAS_BEEN(x) millis() - timeMark > x
#define TIME_MARK() timeMark = millis();

#define CHANGE_STATE(x) {                   \
    /*DEBUG_PRINT("CS %d -> %d (%d)\n",state,x, __LINE__); */  \
    state = x;                              \
    TIME_MARK();                            \
}

#define SET_ERROR(error) {                        \
    strncpy(lastError, error, 500);               \
}

enum State {
  M_RESET,
  M_POWER_ON,
  M_ERROR,
  M_CHECK_AT,
  M_POLL,
  M_SET_APN,
  M_NET_CLOSE,
  M_NET_OPEN,
  M_READY,
  M_DNS_LOOKUP,
  M_CONNECTING,
  M_STOPPING,
  M_CONNECTED,
  M_WAITING_TO_SEND,
  M_SENDING,
};

class ModemClient {

public:
  // constructor
  ModemClient(HardwareSerial modem, uint8_t pwr);

  char lastError[500];
  int connect(const char *host, uint16_t port);
  void stop();
  size_t write(const uint8_t *buf, size_t size);
  int available();
  int read(); 
  char* getline();
  bool connected();
  const char *get_error();
  bool initialized();
  bool isError();
  void on();
  void off();
  void reset();
  void init();
  
  void process(); // Non-blocking, call regularly in main loop.

protected:
  HardwareSerial modem;
  struct MemBuffer tx;
  struct MemBuffer rx;
  struct MemBuffer tcp_rx;
  struct MemBuffer tcp_tx;
  size_t tcp_bytes_to_recv = 0;
  size_t tcp_bytes_to_send = 0;

  uint8_t pwr;
  enum State state = M_ERROR;
  uint32_t timeMark;
  uint32_t poll_count = DEFAULT_POLL_COUNT;
  int expected_errors = 0;
  int expected_ok =0;
  int poll_ok =0;
  int net_close_ok =0;  

  char ip[16]; // XXX.XXX.XXX.XXX
  uint16_t port;

  char _at[200];

  void _processSerial();
  void _tick();
  void _change_state(State nState);

  void modem_reset();
  void modem_send_at();
  void modem_set_apn();
  void modem_open_network();
  void modem_close_network();
  void modem_connect();
  void modem_send();
  void modem_off();
  void modem_on();
  void modem_close();
};

#endif
