oats-center/data-diode/(commit log)

2023-03-08 Added diode stream script.
2024-01-05 Data Diode final codebase.
    [BCS-108-F-D-TE.stp, BCS-110-F-D-TE.stp, BCS-115-L-D-TE.stp, BCS-117-L-D-TE.stp, TSC_STM.kicad_sch, WQ-48-02-Just-Box.step, WorldSide.kicad_sch, dev-boards.kicad_pcb]
