oats-center/data-diode/(notices)

Notices in the files:
DATA_DIODE_FINAL/Data_Diode_efficient_heap_based/World_Side_STM32/CircularBuffer.h:
This program is free software: you can redistribute it and/or modify
it under the terms of the GNU Lesser General Public License as
published by the Free Software Foundation, either version 3 of the
License, or (at your option) any later version.
DATA_DIODE_FINAL/PCB/dev-boards/models/BCS-115-L-D-TE.stp:
author */ ('License CC BY-ND 4.0'),
